leosalustri/SRT_Libraries/DL-RFM95-868M/IC16_RFM95W-915S2_RFS.step

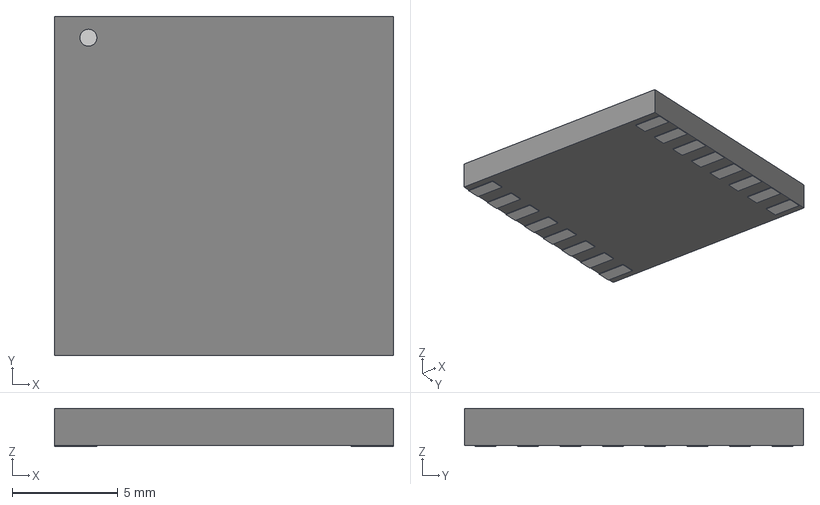
[picture p1: CAD file, 2025-01-29]
DL-RFM95-868M/IC16_RFM95W-915S2_RFS.step
16.0 x 16.0 x 1.81 mm
