leosalustri/SRT_Libraries/DM3CS-SF/DM3CS-SF.stp

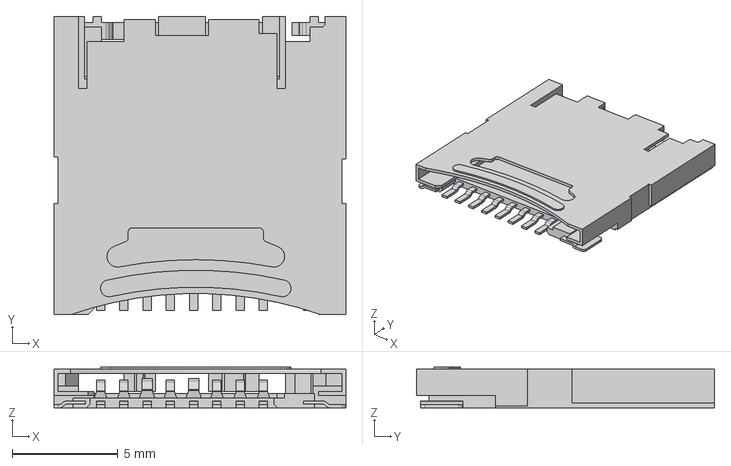
[picture p2: CAD file, 2025-01-29]
DM3CS-SF/DM3CS-SF.stp
13.8 x 14.1 x 1.93 mm
