leosalustri/SRT_Libraries/MPM3610/MPM3610AGQV-P--3DModel-STEP-269445.STEP

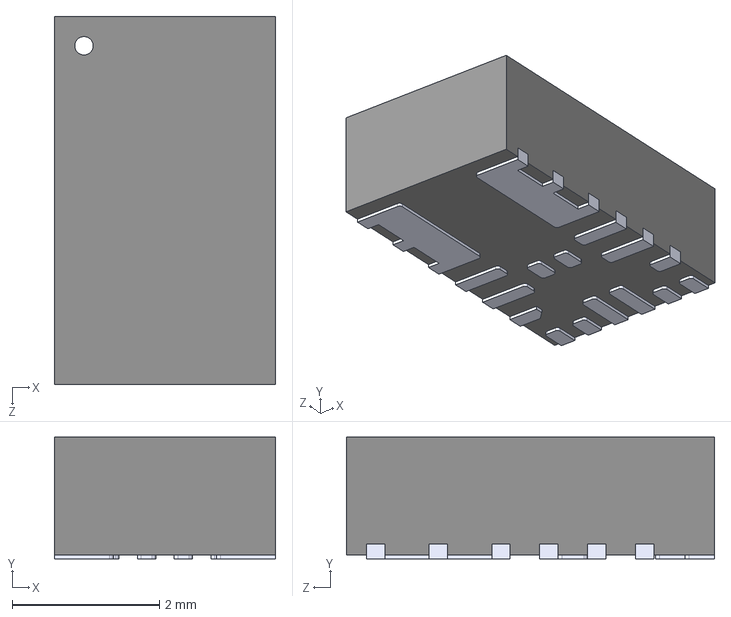
[picture p3: CAD file, 2025-01-29]
MPM3610/MPM3610AGQV-P--3DModel-STEP-269445.STEP
3.00 x 1.65 x 5.00 mm
