leosalustri/SRT_Libraries/Sensors/10LGA_2X2X0p75_BOS.step

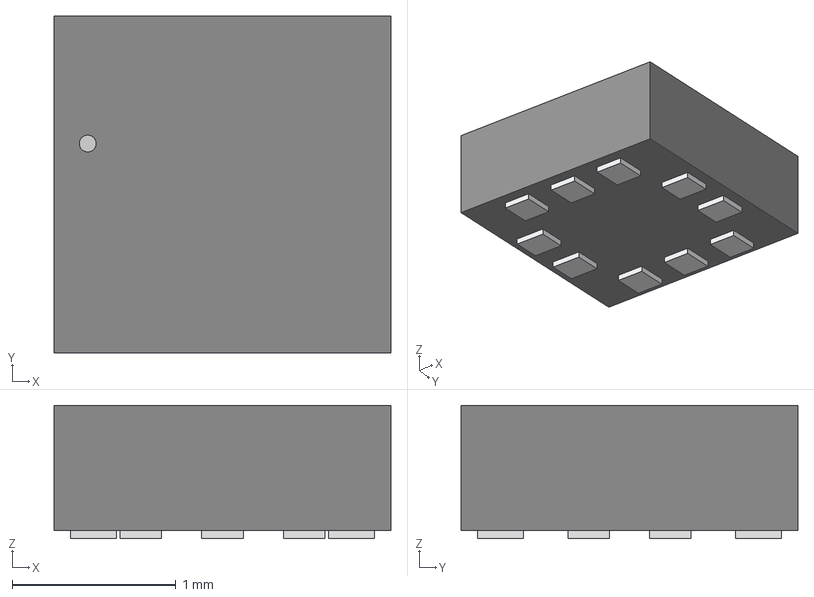
[picture p4: CAD file, 2025-01-29]
Sensors/10LGA_2X2X0p75_BOS.step
2.06 x 2.06 x 0.815 mm
