leosalustri/SRT_Libraries/VND5160AJTR-E/POWERSSO-12_STM.step

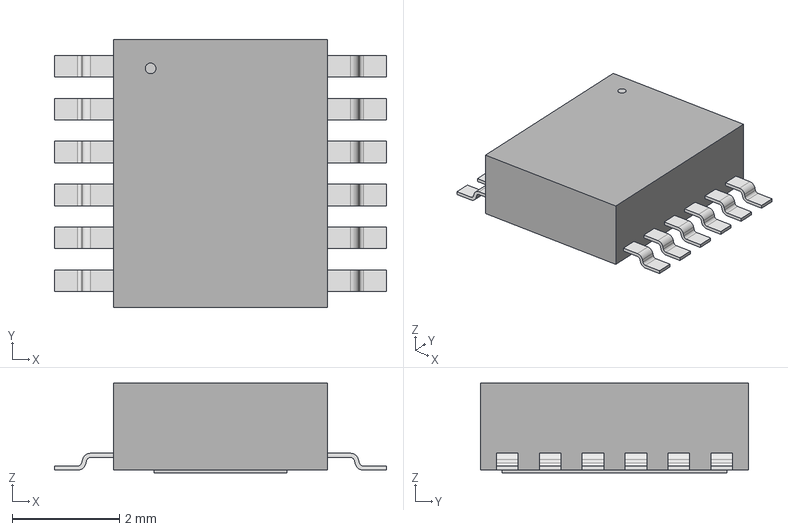
[picture p5: CAD file, 2025-01-29]
VND5160AJTR-E/POWERSSO-12_STM.step
6.20 x 5.00 x 1.68 mm
