leosalustri/SRT_Libraries/Sensors/LIS3MDLTR.stp

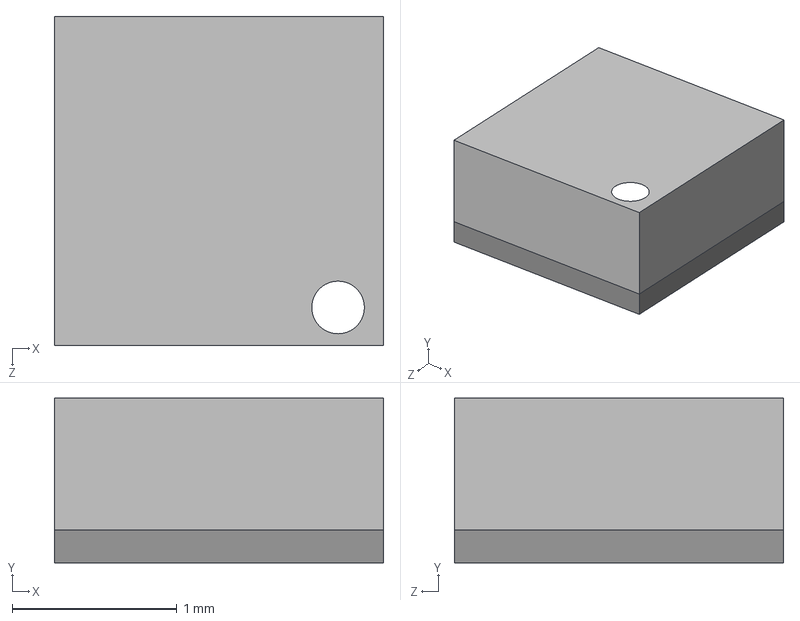
[picture p6: CAD file, 2025-01-29]
Sensors/LIS3MDLTR.stp
2.00 x 1.00 x 2.00 mm
