leosalustri/SRT_Libraries/Sensors/LGA-14L_2P5X3X0P83_STM.step

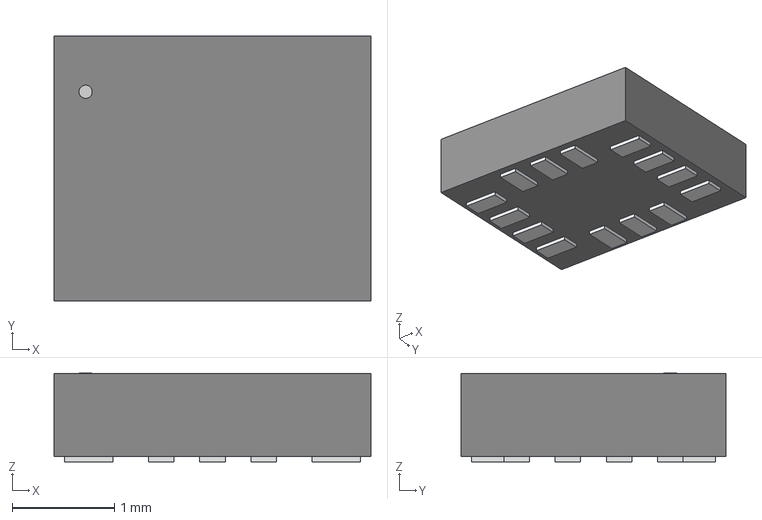
[picture p7: CAD file, 2025-01-29]
Sensors/LGA-14L_2P5X3X0P83_STM.step
3.10 x 2.59 x 0.866 mm
