leosalustri/SRT_Libraries/Molex NanoFit/3d_models/1054051104.stp

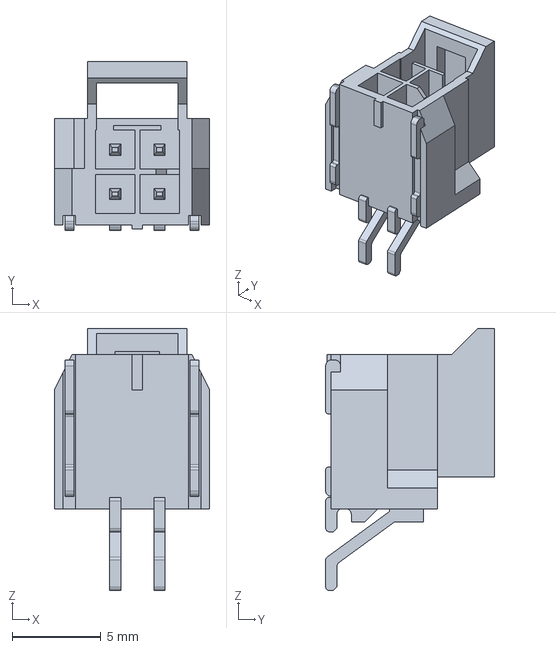
[picture p8: CAD file, 2025-01-29]
Molex NanoFit/3d_models/1054051104.stp
8.74 x 9.49 x 14.7 mm
