leosalustri/SRT_Libraries/Molex NanoFit/3d_models/1054301102.stp

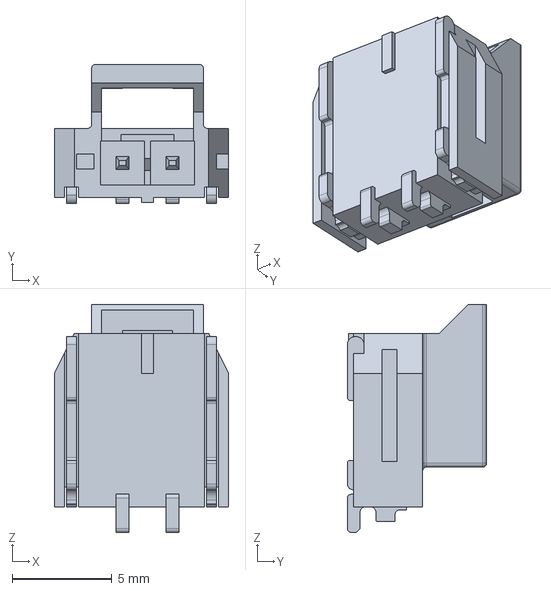
[picture p9: CAD file, 2025-01-29]
Molex NanoFit/3d_models/1054301102.stp
8.74 x 6.99 x 11.4 mm
