leosalustri/SRT_Libraries/Molex NanoFit/3d_models/1053141104.stp

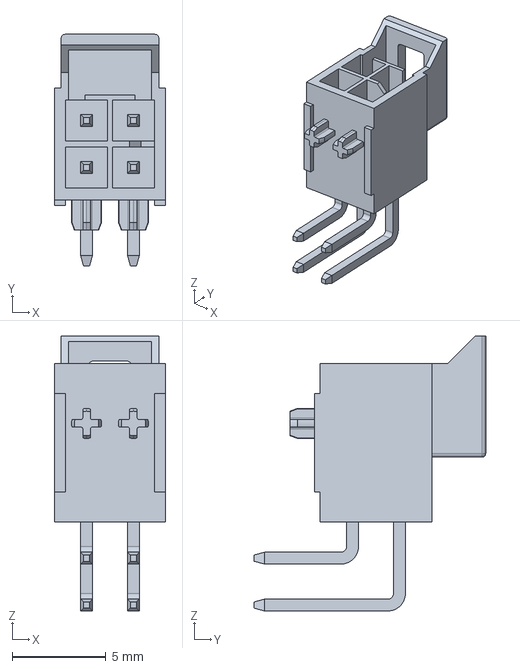
[picture p10: CAD file, 2025-01-29]
Molex NanoFit/3d_models/1053141104.stp
5.94 x 12.3 x 14.7 mm
