leosalustri/SRT_Libraries/Molex NanoFit/3d_models/1053131102.stp

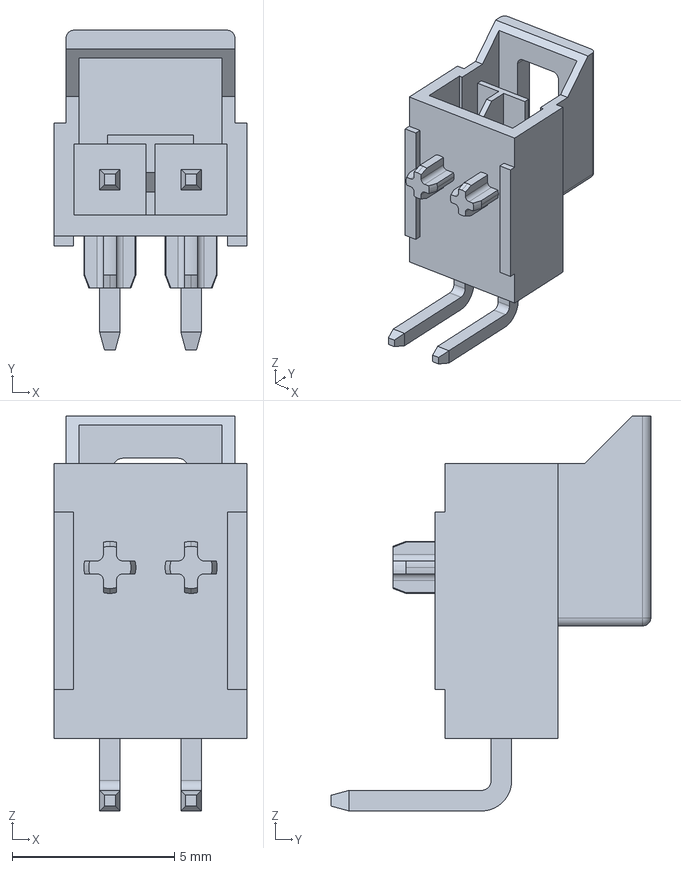
[picture p11: CAD file, 2025-01-29]
Molex NanoFit/3d_models/1053131102.stp
5.94 x 9.84 x 12.2 mm
