leosalustri/SRT_Libraries/Molex NanoFit/3d_models/1054291104.stp

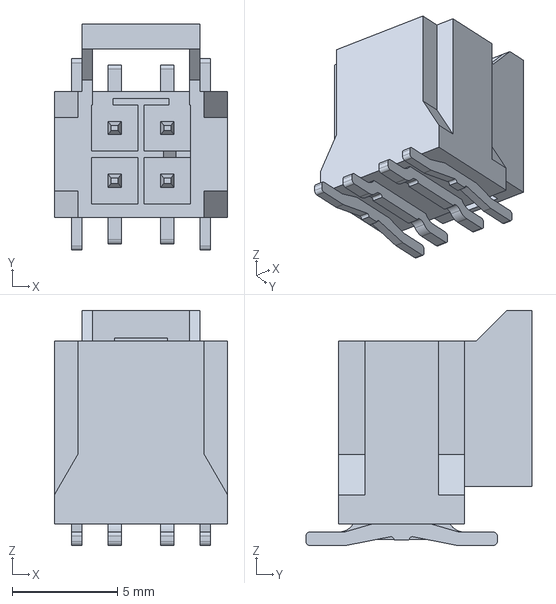
[picture p12: CAD file, 2025-01-29]
Molex NanoFit/3d_models/1054291104.stp
8.23 x 10.8 x 11.2 mm
