leosalustri/SRT_Libraries/Molex NanoFit/3d_models/1053091102.stp

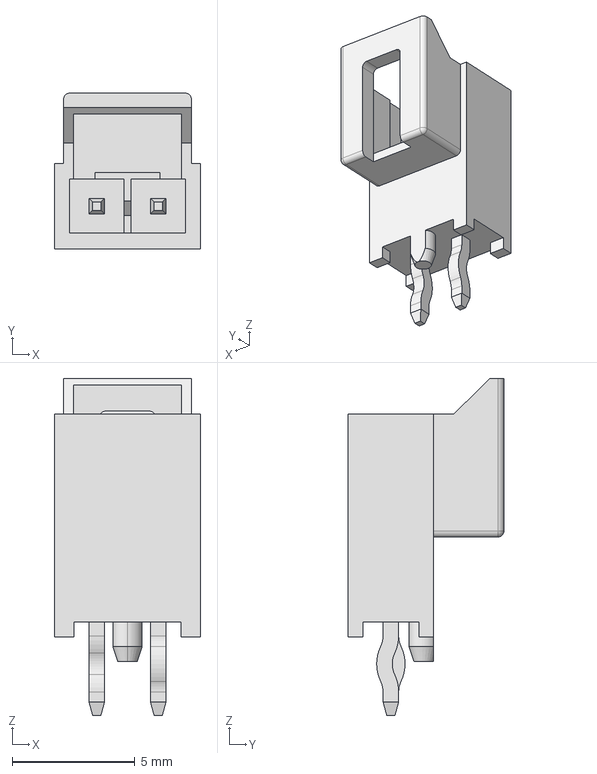
[picture p13: CAD file, 2025-01-29]
Molex NanoFit/3d_models/1053091102.stp
5.94 x 6.34 x 13.7 mm
