leosalustri/SRT_Libraries/Molex NanoFit/3d_models/1054311102.stp

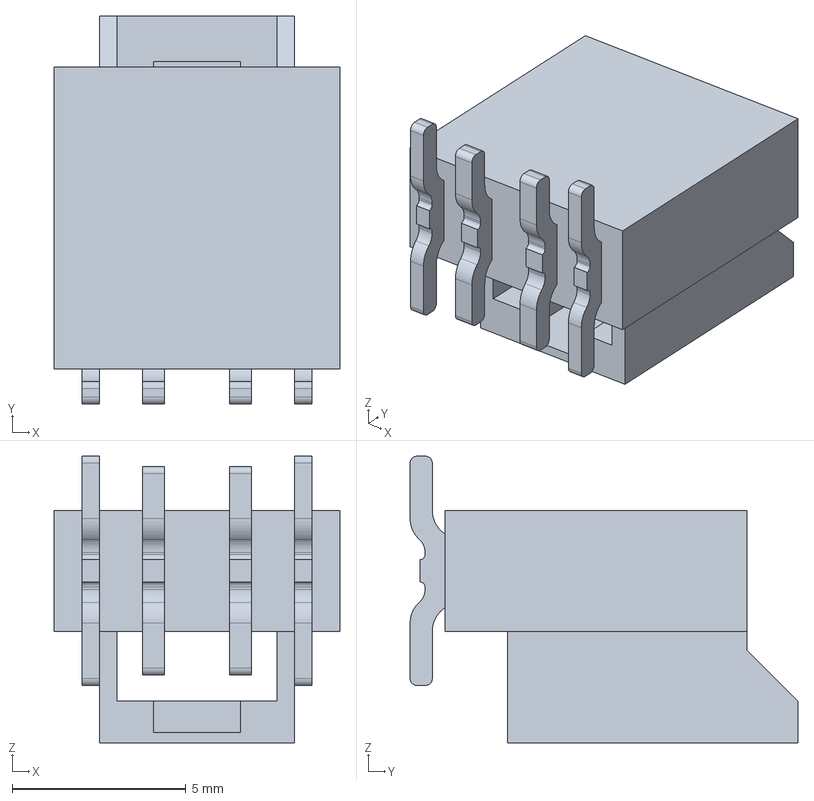
[picture p14: CAD file, 2025-01-29]
Molex NanoFit/3d_models/1054311102.stp
8.23 x 11.2 x 8.25 mm
